FriesW/Elektrosluch-3/BOM.md

| Part Number | Manufacturer | Type | Value | Quantity | Reference Designators |
| --- | --- | ---- | ----- | --- | --- |
| [EEE-HA1C221XP](https://www.mouser.com/ProductDetail/EEE-HA1C221XP) | Panasonic | Electrolytic Capacitor | 220uF 16V | 2 | C1, C2 |
| [593](https://www.mouser.com/ProductDetail/534-593) | Keystone | Battery Snap | Male | 1 | "-" Symbol |
| [594](https://www.mouser.com/ProductDetail/534-594) | Keystone | Battery Snap | Female | 1 | "+" Symbol |
| [FKP2O100471D00KSSD](https://www.mouser.com/ProductDetail/FKP2O100471D00KSSD) | WIMA | Film Capacitor | 47pF 1KV | 2 | C3, C8 |
| [MKS2C042201K00KSSD](https://www.mouser.com/ProductDetail/MKS2C042201K00KSSD) | WIMA | Film Capacitor | 2.2uF 63V | 4 | C4, C5, C6, C7 |
| [13R226C](https://www.mouser.com/ProductDetail/13R226C) | Murata | Inductor | 22mH | 2 | L1, L2 |
| [OPA2134UA/2K5](http://www.mouser.com/ProductDetail/OPA2134UA-2K5) | TI | IC | Audio Amp | 1 | P1 |
| [35RASMT4BHNTRX](http://www.mouser.com/ProductDetail/35RASMT4BHNTRX) | Switchcraft | Jack | 3.5mm | 2 | J1, J2 |
| [RK0971221Z05](http://www.mouser.com/ProductDetail/RK0971221Z05) | ALPS | Poteniometer | 2-gang 10k | 1 | RV1 |
| [AS08J1003ET](http://www.mouser.com/ProductDetail/AS08J1003ET) | Ohmite | Resistor | 100k | 2 | R1, R2 |
| [AS08J1001ET](http://www.mouser.com/ProductDetail/AS08J1001ET) | Ohmite | Resistor | 1k | 4 | R3, R4, R6, R8 |
| [ERJ-6GEYJ394V](http://www.mouser.com/ProductDetail/ERJ-6GEYJ394V) | Panasonic | Resistor | 390k | 2 | R5, R7 |
| [LS R976-NR-1](http://www.mouser.com/ProductDetail/LS%20R976-NR-1) | OSRAM | LED | 633nm, red | 2 | D1, D2 |
