FriesW/Elektrosluch-3/hardware/Elektrosluch-3-Mini.kicad_pcb

## KiCad design hardware/Elektrosluch-3-Mini.kicad_pcb (2017-01-17)

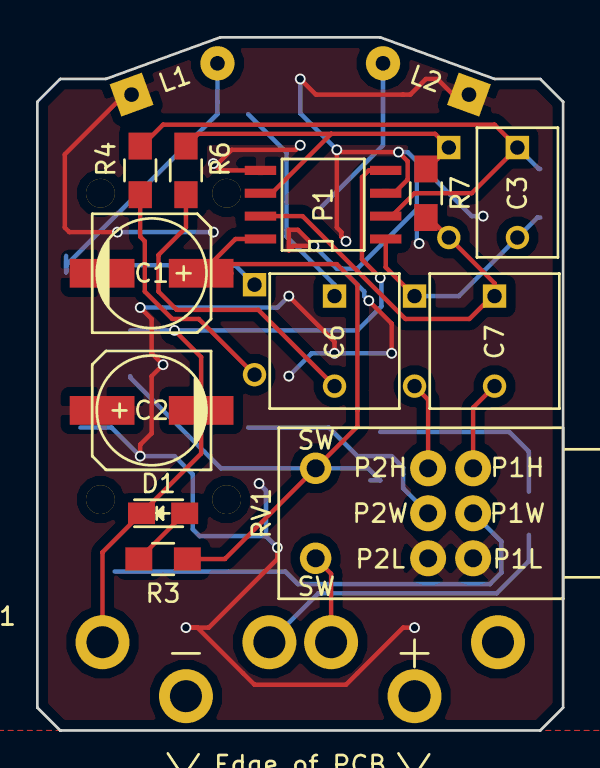
[picture p1: board Elektrosluch-3-Mini.kicad_pcb from above]

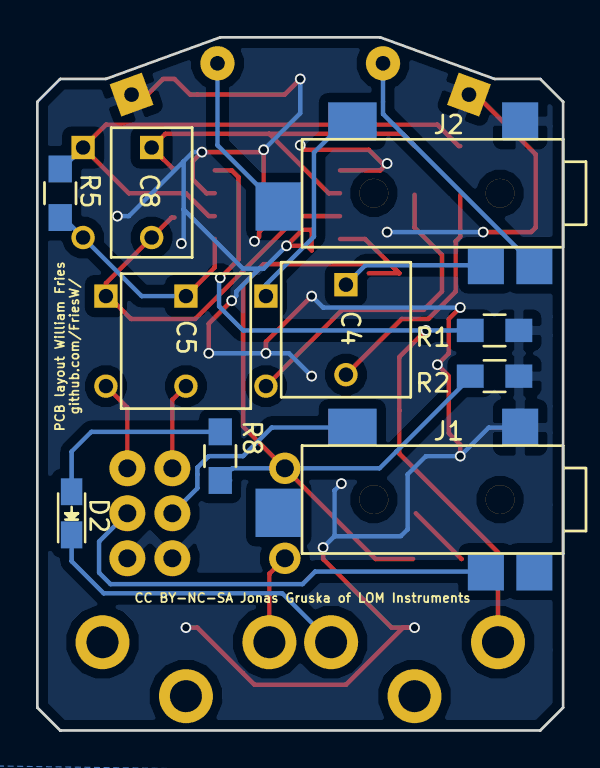
[picture p2: board Elektrosluch-3-Mini.kicad_pcb from below]

Board: 2 copper layers, 29.2 x 38.5 mm, 25 parts (10 on the bottom side), 20 nets.

Parts:
BT1: 9V; 9V_Battery_Snaps
C1, C2: 220uF; c_elec_6.3x7.7
C3, C8: 47pF; C_Rect_L7.2_W4.5_P5
C4, C5, C6, C7: 2.2uF; C_Rect_L7.2_W7.2_P5
D1, D2: LED; LED-0805-HandSoldering
J1, J2: JACK_TRS_5PINS; Switchcraft_TRS_Jack_SMD
L1, L2: 22mH; INDUCTOR_V_WO_CIRCLE
P1: DIL8; SOIC-8-N-HandSoldering
R1, R2: 100k; R_0805_HandSoldering
R3, R4, R6, R8: 1k; R_0805_HandSoldering
R5, R7: 390k; R_0805_HandSoldering
RV1: DUAL_SWITCHED_POT; Dual_Switched_Pot

Connections:
+5V: C1.1, P1.8, R1.1, R3.1, R8.1, RV1.7
-5V: BT1.2, C2.2, D1.1, D2.1, P1.4, R2.2
/AO1: C3.2, C5.1, P1.1, R5.2
/AO2: C7.1, C8.2, P1.7, R7.2
/CH1: C3.1, P1.2, R4.2, R5.1
/CH2: C8.1, P1.6, R6.2, R7.1
GND: C1.2, C2.1, J1.1, J2.1, L1.1, L2.1, P1.3, P1.5, R1.2, R2.1, RV1.3, RV1.6
unnamed: BT1.1, RV1.8
unnamed: C4.1, J2.3
unnamed: C4.2, R4.1
unnamed: C5.2, RV1.4
unnamed: C6.1, J2.2
unnamed: C6.2, R6.1
unnamed: C7.2, RV1.1
unnamed: D1.2, R3.2
unnamed: D2.2, R8.2
unnamed: J1.2, RV1.5
unnamed: J1.3, RV1.2
unnamed: J2.4, L2.2
unnamed: J2.5, L1.2
