FriesW/Elektrosluch-3/(commit log)

2017-01-17 Added KiCad Library to Readme
2017-01-17 Hardware
    Added KiCad files, removed Eagle files.
    [Elektrosluch-3-Mini.kicad_pcb, Elektrosluch-3-Mini.sch, elektrosluch.brd, elektrosluch.sch]
2017-01-18 Create BOM.md
    Still need to add Reference Designators.
2017-01-18 Update BOM.md
    Added Reference Designators and LEDs.
2017-01-18 Completed BOM
    Finished LED entry.
2017-01-18 Completed BOM
    This one is actually complete. I forgot to add reference designators for battery clips.
2019-12-15 Fix BOM Links
    Because Mouser broke all my saved URLs...
