FriesW/Elektrosluch-3/(notices)

Notices in the files:
hardware/Elektrosluch-3-Mini.sch:
Licensed under CC BY-NC-SA by Jonas Gruska / LOM Instruments
hardware/Elektrosluch-3-Mini.kicad_pcb:
Circuit licensed under CC BY-NC-SA by Jonas Gruska / LOM Instruments
CC BY-NC-SA Jonas Gruska of LOM Instruments
